svenssonjoel/Mattie/README.md

# Mattie
stM32f4 lATTIcE - MATTIE - A PCB with an STM32f4 and a LATTICE FPGA
