svenssonjoel/Mattie/hardware/mattie_v0/mattie_v0.kicad_pcb

## KiCad design hardware/mattie_v0/mattie_v0.kicad_pcb (2020-05-09)

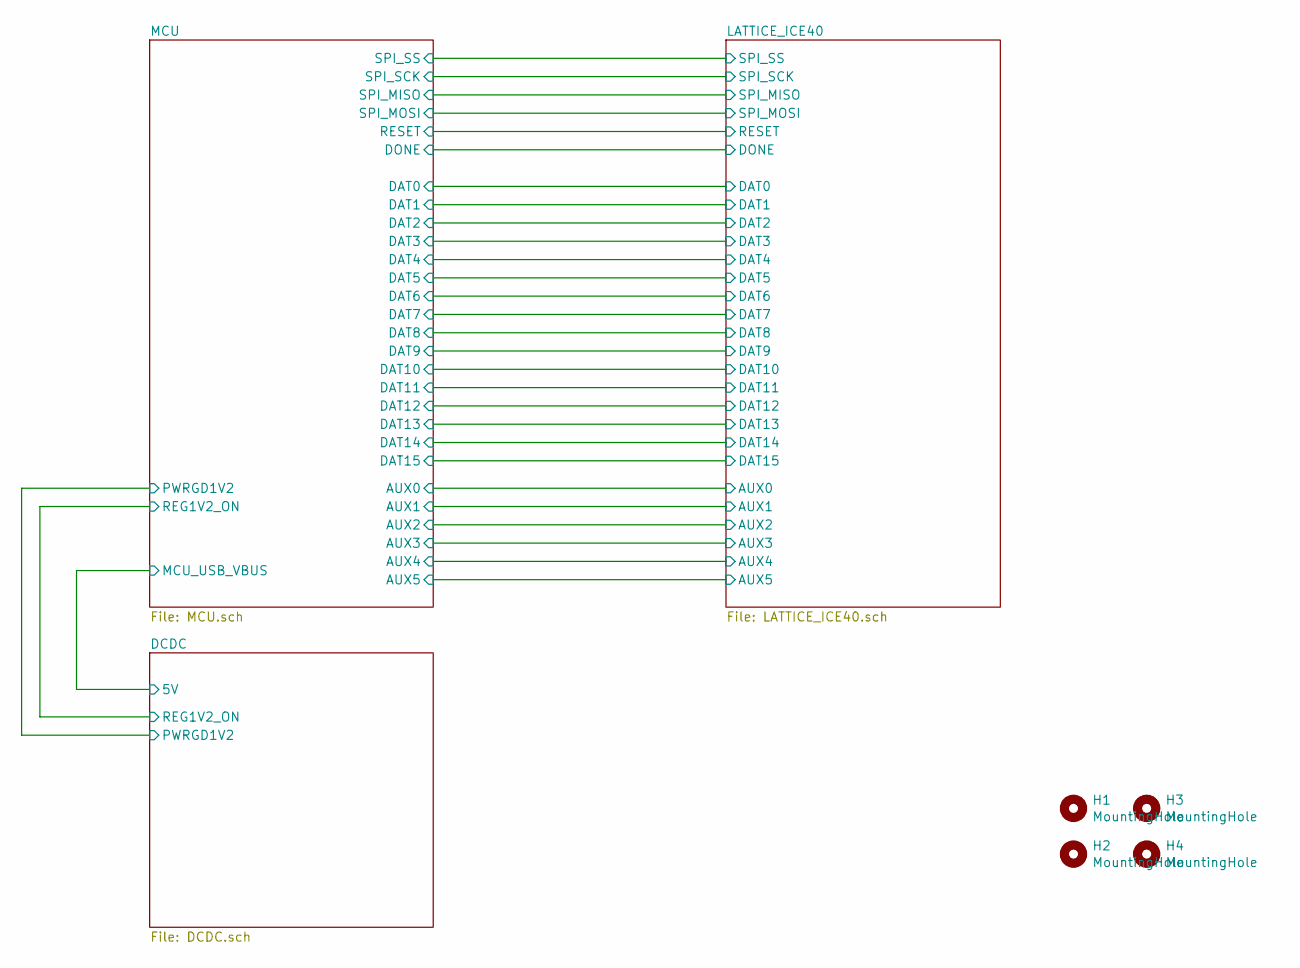
[picture p8: schematic mattie_v0.sch, Mattie Version 0]

Parts:
H1, H2, H3, H4: MountingHole; MountingHole_3.2mm_M3

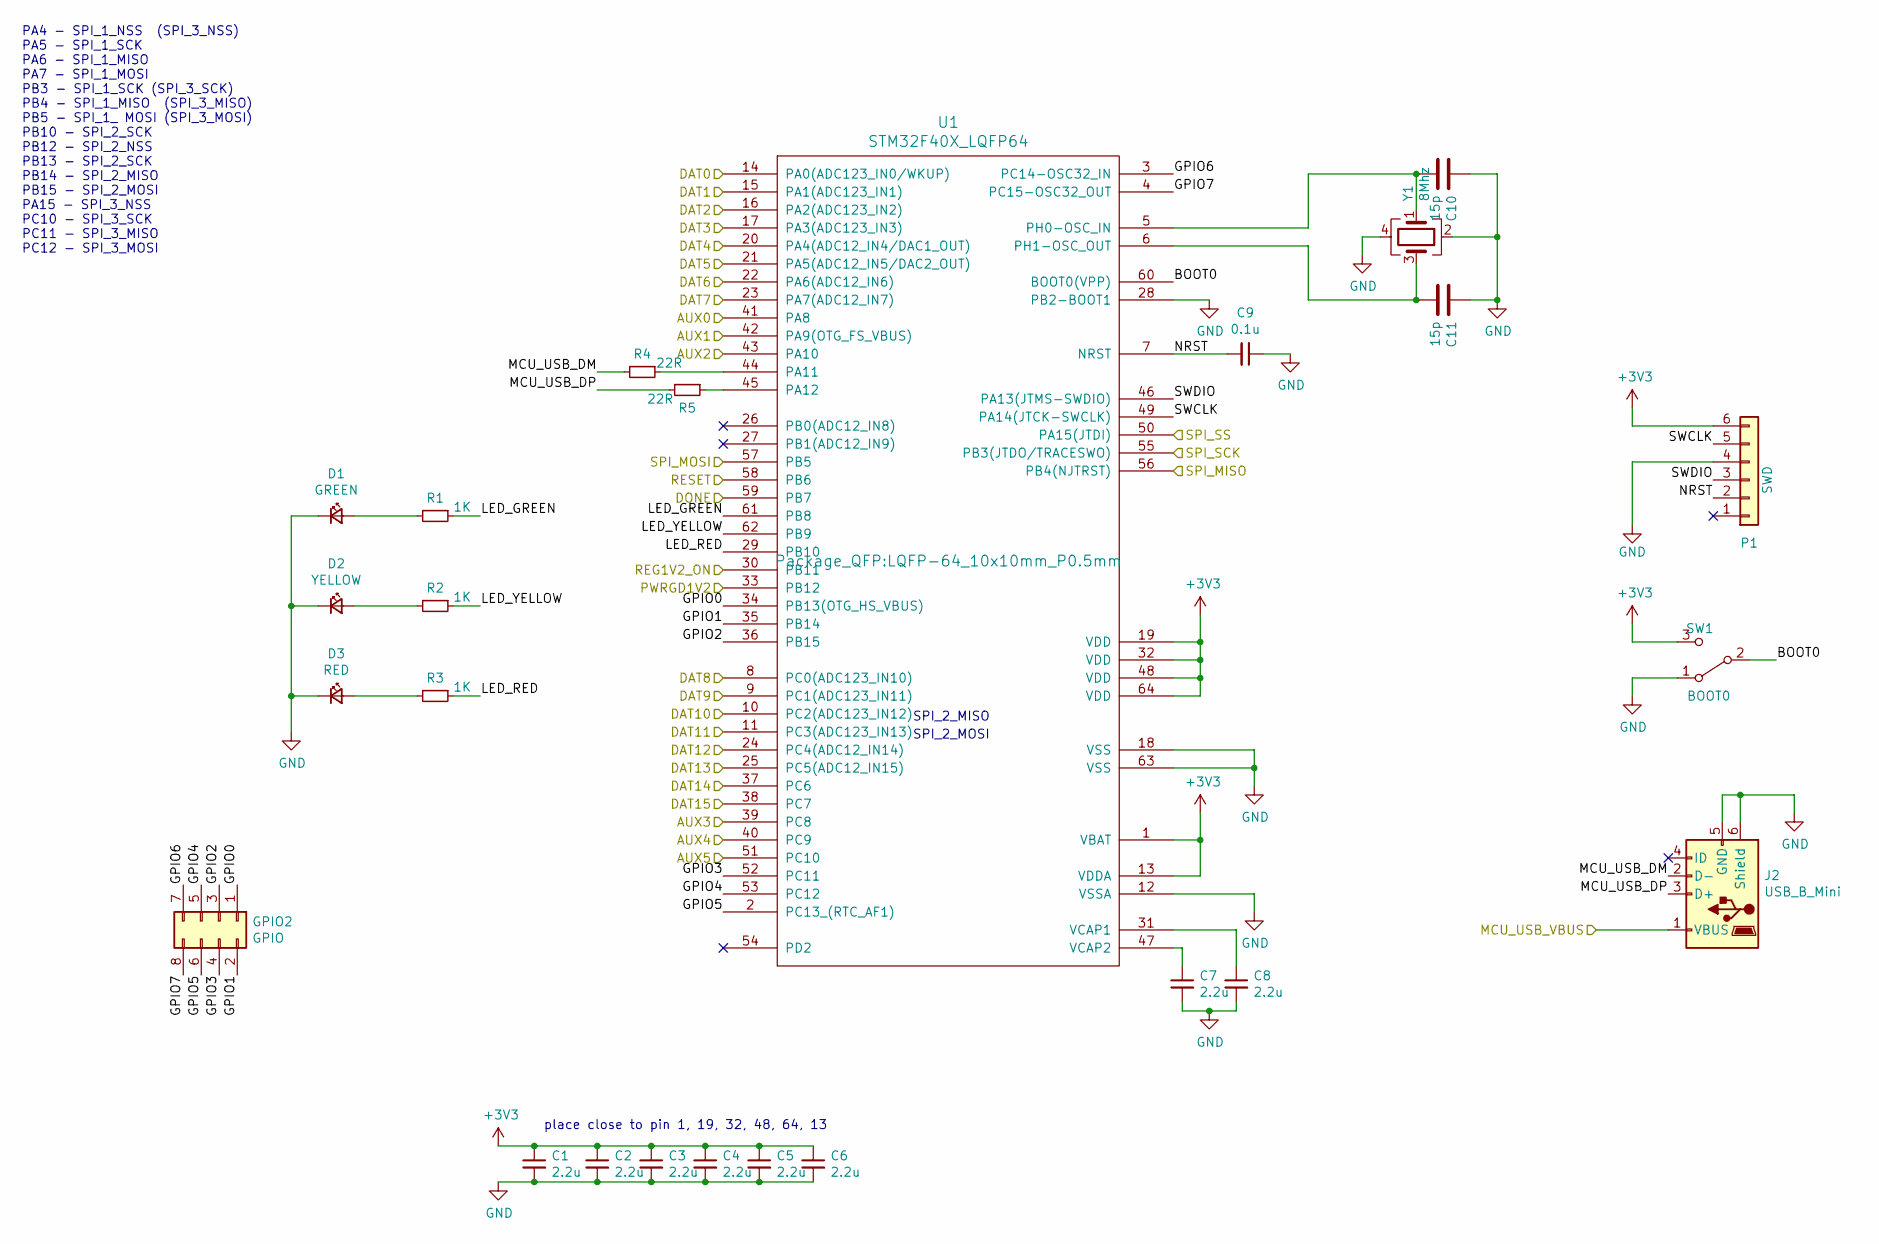
[picture p9: schematic MCU.sch, Mattie Version 0]

Parts:
C1, C2, C3, C4, C5, C6, C7, C8: 2.2u; C_0603_1608Metric
C9: 0.1u; C_0603_1608Metric
C10, C11: 15p; C_0603_1608Metric
D1: GREEN; LED_0603_1608Metric
D2: YELLOW; LED_0603_1608Metric
D3: RED; LED_0603_1608Metric
GPIO2: GPIO; PinHeader_2x04_P2.54mm_Vertical
J2: USB_B_Mini; USB_Mini-B_Lumberg_2486_01_Horizontal
P1: SWD; JST_PH_B6B-PH-K_1x06_P2.00mm_Vertical
R1, R2, R3: 1K; R_0603_1608Metric
R4, R5: 22R; R_0603_1608Metric
SW1: BOOT0; SW_SPDT_PCM12
U1: STM32F40X_LQFP64; LQFP-64_10x10mm_P0.5mm
Y1: 8Mhz; Crystal_SMD_5032-4Pin_5.0x3.2mm

Connections:
+3V3: C1.1, C2.1, C3.1, C4.1, C5.1, C6.1, P1.6, SW1.3 (C), U1.1 (VBAT), U1.13 (VDDA), U1.19 (VDD), U1.32 (VDD), U1.48 (VDD), U1.64 (VDD); also elsewhere on the board
/DCDC/5V: J2.1 (VBUS); also elsewhere on the board
/DCDC/PWRGD1V2: U1.33 (PB12); also elsewhere on the board
/DCDC/REG1V2_ON: U1.30 (PB11); also elsewhere on the board
/LATTICE_ICE40/AUX0: U1.41 (PA8); also elsewhere on the board
/LATTICE_ICE40/AUX1: U1.42 (PA9(OTG_FS_VBUS)); also elsewhere on the board
/LATTICE_ICE40/AUX2: U1.43 (PA10); also elsewhere on the board
/LATTICE_ICE40/AUX3: U1.39 (PC8); also elsewhere on the board
/LATTICE_ICE40/AUX4: U1.40 (PC9); also elsewhere on the board
/LATTICE_ICE40/AUX5: U1.51 (PC10); also elsewhere on the board
/LATTICE_ICE40/DAT0: U1.14 (PA0(ADC123_IN0/WKUP)); also elsewhere on the board
/LATTICE_ICE40/DAT1: U1.15 (PA1(ADC123_IN1)); also elsewhere on the board
/LATTICE_ICE40/DAT2: U1.16 (PA2(ADC123_IN2)); also elsewhere on the board
/LATTICE_ICE40/DAT3: U1.17 (PA3(ADC123_IN3)); also elsewhere on the board
/LATTICE_ICE40/DAT4: U1.20 (PA4(ADC12_IN4/DAC1_OUT)); also elsewhere on the board
/LATTICE_ICE40/DAT5: U1.21 (PA5(ADC12_IN5/DAC2_OUT)); also elsewhere on the board
/LATTICE_ICE40/DAT6: U1.22 (PA6(ADC12_IN6)); also elsewhere on the board
/LATTICE_ICE40/DAT7: U1.23 (PA7(ADC12_IN7)); also elsewhere on the board
/LATTICE_ICE40/DAT8: U1.8 (PC0(ADC123_IN10)); also elsewhere on the board
/LATTICE_ICE40/DAT9: U1.9 (PC1(ADC123_IN11)); also elsewhere on the board
/LATTICE_ICE40/DAT10: U1.10 (PC2(ADC123_IN12)); also elsewhere on the board
/LATTICE_ICE40/DAT11: U1.11 (PC3(ADC123_IN13)); also elsewhere on the board
/LATTICE_ICE40/DAT12: U1.24 (PC4(ADC12_IN14)); also elsewhere on the board
/LATTICE_ICE40/DAT13: U1.25 (PC5(ADC12_IN15)); also elsewhere on the board
/LATTICE_ICE40/DAT14: U1.37 (PC6); also elsewhere on the board
/LATTICE_ICE40/DAT15: U1.38 (PC7); also elsewhere on the board
/LATTICE_ICE40/DONE: U1.59 (PB7); also elsewhere on the board
/LATTICE_ICE40/RESET: U1.58 (PB6); also elsewhere on the board
/LATTICE_ICE40/SPI_MISO: U1.56 (PB4(NJTRST)); also elsewhere on the board
/LATTICE_ICE40/SPI_MOSI: U1.57 (PB5); also elsewhere on the board
/LATTICE_ICE40/SPI_SCK: U1.55 (PB3(JTDO/TRACESWO)); also elsewhere on the board
/LATTICE_ICE40/SPI_SS: U1.50 (PA15(JTDI)); also elsewhere on the board
/MCU/BOOT0: SW1.2 (B), U1.60 (BOOT0(VPP))
/MCU/GPIO0: GPIO2.1, U1.34 (PB13(OTG_HS_VBUS))
/MCU/GPIO1: GPIO2.2, U1.35 (PB14)
/MCU/GPIO2: GPIO2.3, U1.36 (PB15)
/MCU/GPIO3: GPIO2.4, U1.52 (PC11)
/MCU/GPIO4: GPIO2.5, U1.53 (PC12)
/MCU/GPIO5: GPIO2.6, U1.2 (PC13_(RTC_AF1))
/MCU/GPIO6: GPIO2.7, U1.3 (PC14-OSC32_IN)
/MCU/GPIO7: GPIO2.8, U1.4 (PC15-OSC32_OUT)
/MCU/LED_GREEN: R1.1, U1.61 (PB8)
/MCU/LED_RED: R3.1, U1.29 (PB10)
/MCU/LED_YELLOW: R2.1, U1.62 (PB9)
/MCU/MCU_USB_DM: J2.2 (D-), R4.2
/MCU/MCU_USB_DP: J2.3 (D+), R5.2
/MCU/NRST: C9.2, P1.2, U1.7 (NRST)
/MCU/SWCLK: P1.5, U1.49 (PA14(JTCK-SWCLK))
/MCU/SWDIO: P1.3, U1.46 (PA13(JTMS-SWDIO))
GND: C1.2, C2.2, C3.2, C4.2, C5.2, C6.2, C7.2, C8.2, C9.1, C10.1, C11.1, D1.1 (K), D2.1 (K), D3.1 (K), J2.5 (GND), J2.6 (Shield), P1.4, SW1.1 (A), U1.12 (VSSA), U1.18 (VSS), U1.28 (PB2-BOOT1), U1.63 (VSS), Y1.2, Y1.4; also elsewhere on the board
unnamed: C7.1, U1.47 (VCAP2)
unnamed: C8.1, U1.31 (VCAP1)
unnamed: C10.2, U1.5 (PH0-OSC_IN), Y1.1
unnamed: C11.2, U1.6 (PH1-OSC_OUT), Y1.3
unnamed: D1.2 (A), R1.2
unnamed: D2.2 (A), R2.2
unnamed: D3.2 (A), R3.2
unnamed: R4.1, U1.44 (PA11)
unnamed: R5.1, U1.45 (PA12)

Notes on the sheet:
SPI_2_MISO
SPI_2_MOSI
PA4 - SPI_1_NSS (SPI_3_NSS) PA5 - SPI_1_SCK PA6 - SPI_1_MISO PA7 - SPI_1_MOSI PB3 - SPI_1_SCK (SPI_3_SCK) PB4 - SPI_1_MISO (SPI_3_MISO) PB5 - SPI_1_ MOSI (SPI_3_MOSI) PB10 - SPI_2_SCK PB12 - SPI_2_NSS PB13 - SPI_2_SCK PB14 - SPI_2_MISO PB15 - SPI_2_MOSI PA15 - SPI_3_NSS PC10 - SPI_3_SCK PC11 - SPI_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
place close to pin 1, 19, 32, 48, 64, 13

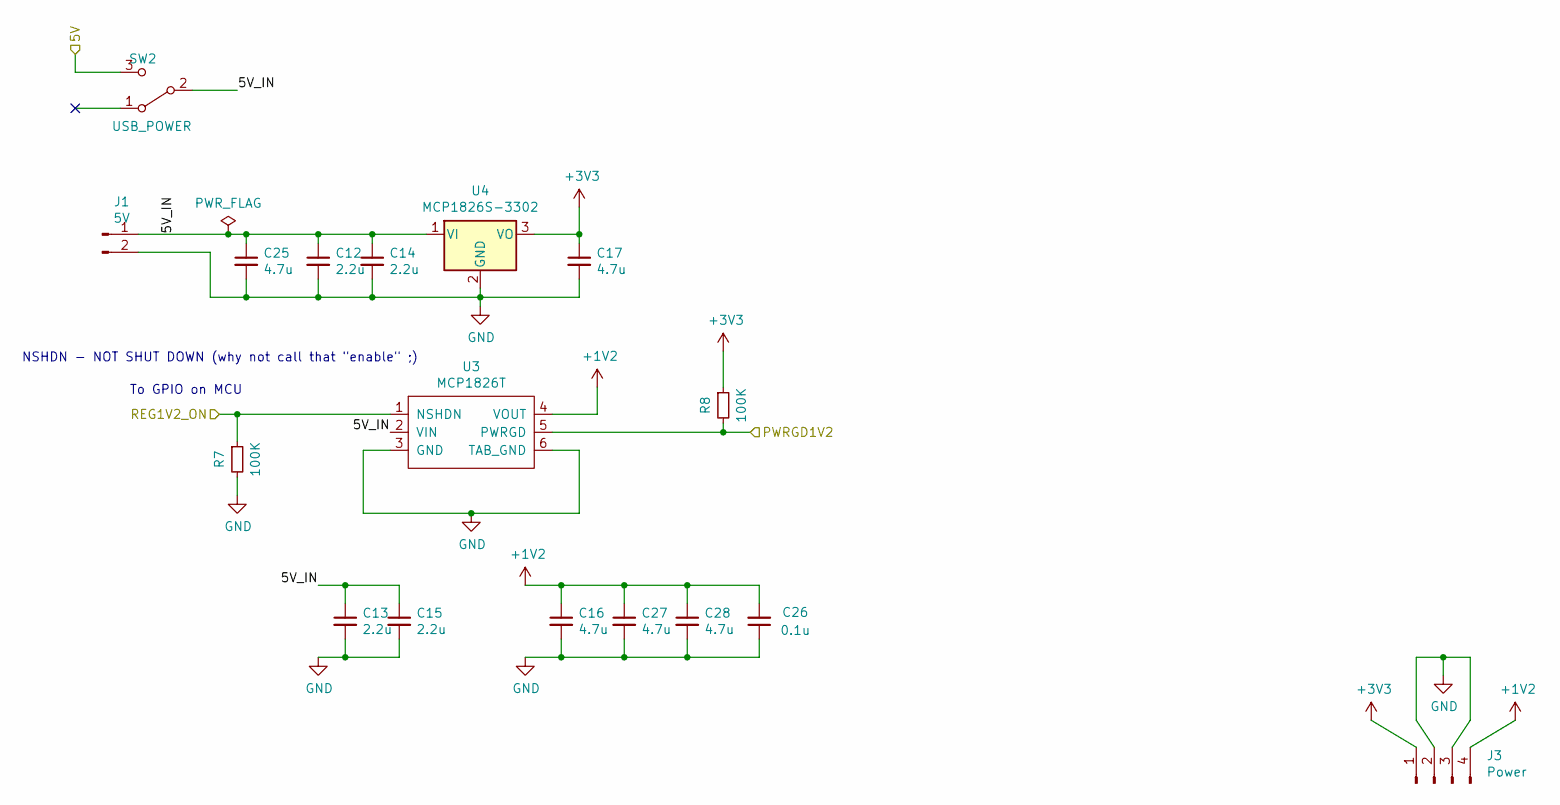
[picture p10: schematic DCDC.sch, Mattie Version 0]

Parts:
C12, C13, C14, C15: 2.2u; C_0603_1608Metric
C16, C17, C25, C27, C28: 4.7u; C_0603_1608Metric
C26: 0.1u; C_0603_1608Metric
J1: 5V; PinHeader_1x02_P2.54mm_Vertical
J3: Power; PinHeader_1x04_P2.54mm_Vertical
R7, R8: 100K; R_0603_1608Metric
SW2: USB_POWER; SW_SPDT_PCM12
U3: MCP1826T; SOT-223-6
U4: MCP1826S-3302; SOT-223-3_TabPin2

Connections:
+1V2: C16.1, C26.2, C27.1, C28.1, J3.4, U3.4 (VOUT); also elsewhere on the board
+3V3: C17.1, J3.1, R8.1, U4.3 (VO); also elsewhere on the board
/DCDC/5V: SW2.3 (C); also elsewhere on the board
/DCDC/5V_IN: C12.1, C13.1, C14.1, C15.1, C25.1, J1.1, SW2.2 (B), U3.2 (VIN), U4.1 (VI)
/DCDC/PWRGD1V2: R8.2, U3.5 (PWRGD); also elsewhere on the board
/DCDC/REG1V2_ON: R7.1, U3.1 (NSHDN); also elsewhere on the board
GND: C12.2, C13.2, C14.2, C15.2, C16.2, C17.2, C25.2, C26.1, C27.2, C28.2, J1.2, J3.2, J3.3, R7.2, U3.3 (GND), U3.6 (TAB_GND), U4.2 (GND); also elsewhere on the board

Notes on the sheet:
To GPIO on MCU
NSHDN - NOT SHUT DOWN (why not call that "enable" ;)

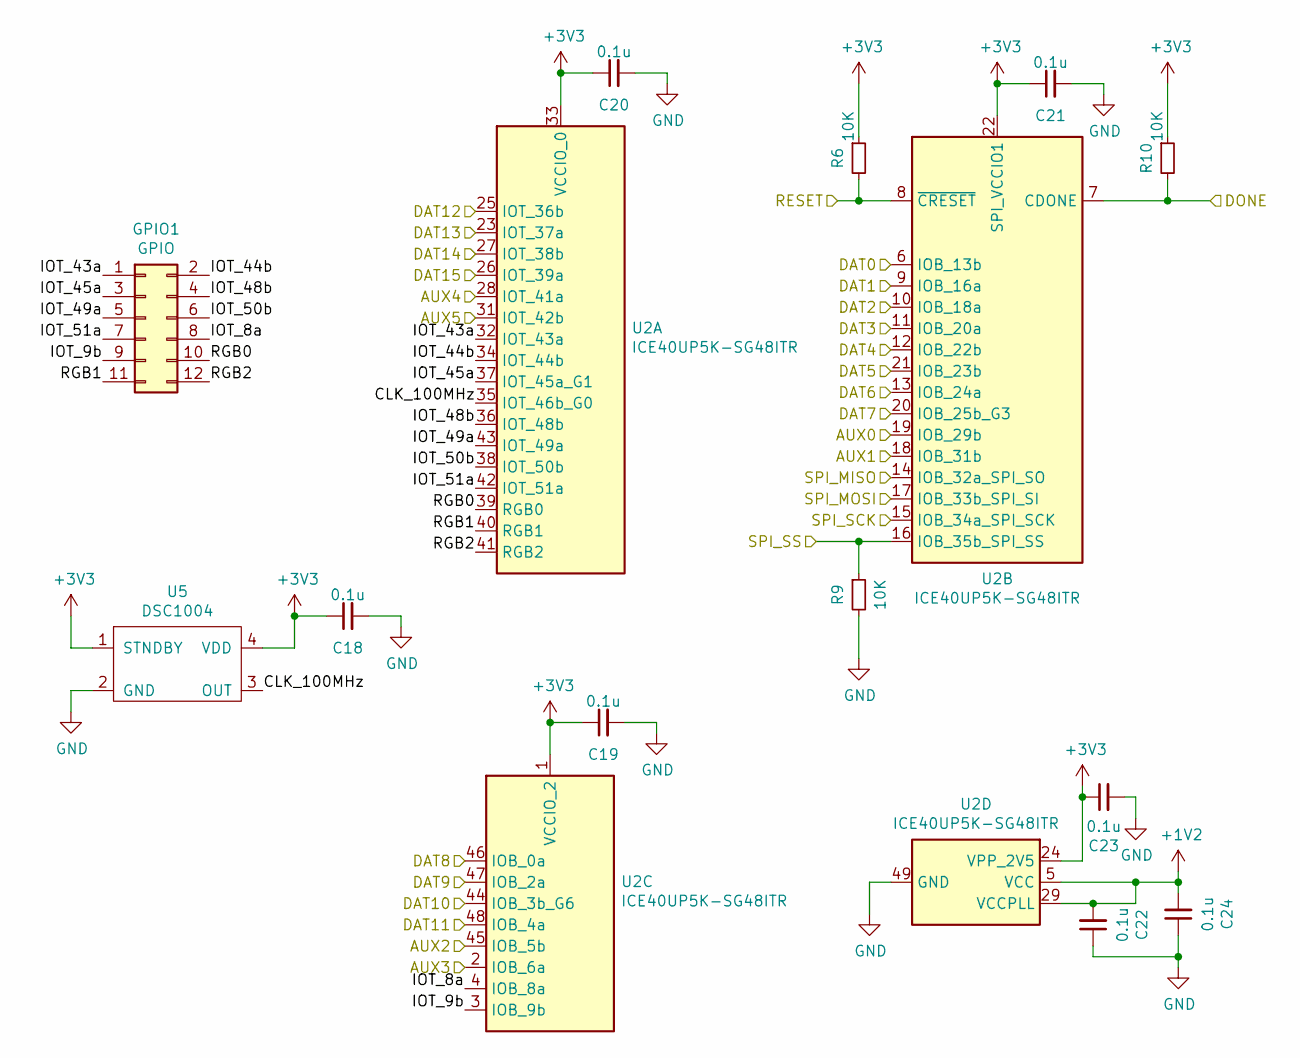
[picture p11: schematic LATTICE_ICE40.sch, Mattie Version 0]

Parts:
C18, C19, C20, C21, C22, C23, C24: 0.1u; C_0603_1608Metric
GPIO1: GPIO; PinHeader_2x06_P2.54mm_Vertical
R6, R9, R10: 10K; R_0603_1608Metric
U2: ICE40UP5K-SG48ITR; QFN-48-1EP_7x7mm_P0.5mm_EP5.45x5.45mm_ThermalVias
U5: DSC1004

Connections:
+1V2: C22.2, C24.2, U2.5 (VCC), U2.29 (VCCPLL), U2.30 (VCC); also elsewhere on the board
+3V3: C18.1, C19.1, C20.1, C21.1, C23.1, R6.1, R10.1, U2.1 (VCCIO_2), U2.22 (SPI_VCCIO1), U2.24 (VPP_2V5), U2.33 (VCCIO_0), U5.1 (STNDBY), U5.4 (VDD); also elsewhere on the board
/LATTICE_ICE40/AUX0: U2.19 (IOB_29b); also elsewhere on the board
/LATTICE_ICE40/AUX1: U2.18 (IOB_31b); also elsewhere on the board
/LATTICE_ICE40/AUX2: U2.45 (IOB_5b); also elsewhere on the board
/LATTICE_ICE40/AUX3: U2.2 (IOB_6a); also elsewhere on the board
/LATTICE_ICE40/AUX4: U2.28 (IOT_41a); also elsewhere on the board
/LATTICE_ICE40/AUX5: U2.31 (IOT_42b); also elsewhere on the board
/LATTICE_ICE40/CLK_100MHz: U2.35 (IOT_46b_G0), U5.3 (OUT)
/LATTICE_ICE40/DAT0: U2.6 (IOB_13b); also elsewhere on the board
/LATTICE_ICE40/DAT1: U2.9 (IOB_16a); also elsewhere on the board
/LATTICE_ICE40/DAT2: U2.10 (IOB_18a); also elsewhere on the board
/LATTICE_ICE40/DAT3: U2.11 (IOB_20a); also elsewhere on the board
/LATTICE_ICE40/DAT4: U2.12 (IOB_22b); also elsewhere on the board
/LATTICE_ICE40/DAT5: U2.21 (IOB_23b); also elsewhere on the board
/LATTICE_ICE40/DAT6: U2.13 (IOB_24a); also elsewhere on the board
/LATTICE_ICE40/DAT7: U2.20 (IOB_25b_G3); also elsewhere on the board
/LATTICE_ICE40/DAT8: U2.46 (IOB_0a); also elsewhere on the board
/LATTICE_ICE40/DAT9: U2.47 (IOB_2a); also elsewhere on the board
/LATTICE_ICE40/DAT10: U2.44 (IOB_3b_G6); also elsewhere on the board
/LATTICE_ICE40/DAT11: U2.48 (IOB_4a); also elsewhere on the board
/LATTICE_ICE40/DAT12: U2.25 (IOT_36b); also elsewhere on the board
/LATTICE_ICE40/DAT13: U2.23 (IOT_37a); also elsewhere on the board
/LATTICE_ICE40/DAT14: U2.27 (IOT_38b); also elsewhere on the board
/LATTICE_ICE40/DAT15: U2.26 (IOT_39a); also elsewhere on the board
/LATTICE_ICE40/DONE: R10.2, U2.7 (CDONE); also elsewhere on the board
/LATTICE_ICE40/IOT_8a: GPIO1.8, U2.4 (IOB_8a)
/LATTICE_ICE40/IOT_9b: GPIO1.9, U2.3 (IOB_9b)
/LATTICE_ICE40/IOT_43a: GPIO1.1, U2.32 (IOT_43a)
/LATTICE_ICE40/IOT_44b: GPIO1.2, U2.34 (IOT_44b)
/LATTICE_ICE40/IOT_45a: GPIO1.3, U2.37 (IOT_45a_G1)
/LATTICE_ICE40/IOT_48b: GPIO1.4, U2.36 (IOT_48b)
/LATTICE_ICE40/IOT_49a: GPIO1.5, U2.43 (IOT_49a)
/LATTICE_ICE40/IOT_50b: GPIO1.6, U2.38 (IOT_50b)
/LATTICE_ICE40/IOT_51a: GPIO1.7, U2.42 (IOT_51a)
/LATTICE_ICE40/RESET: R6.2, U2.8 (~CRESET); also elsewhere on the board
/LATTICE_ICE40/RGB0: GPIO1.10, U2.39 (RGB0)
/LATTICE_ICE40/RGB1: GPIO1.11, U2.40 (RGB1)
/LATTICE_ICE40/RGB2: GPIO1.12, U2.41 (RGB2)
/LATTICE_ICE40/SPI_MISO: U2.14 (IOB_32a_SPI_SO); also elsewhere on the board
/LATTICE_ICE40/SPI_MOSI: U2.17 (IOB_33b_SPI_SI); also elsewhere on the board
/LATTICE_ICE40/SPI_SCK: U2.15 (IOB_34a_SPI_SCK); also elsewhere on the board
/LATTICE_ICE40/SPI_SS: R9.1, U2.16 (IOB_35b_SPI_SS); also elsewhere on the board
GND: C18.2, C19.2, C20.2, C21.2, C22.1, C23.2, C24.1, R9.2, U2.49 (GND), U5.2 (GND); also elsewhere on the board

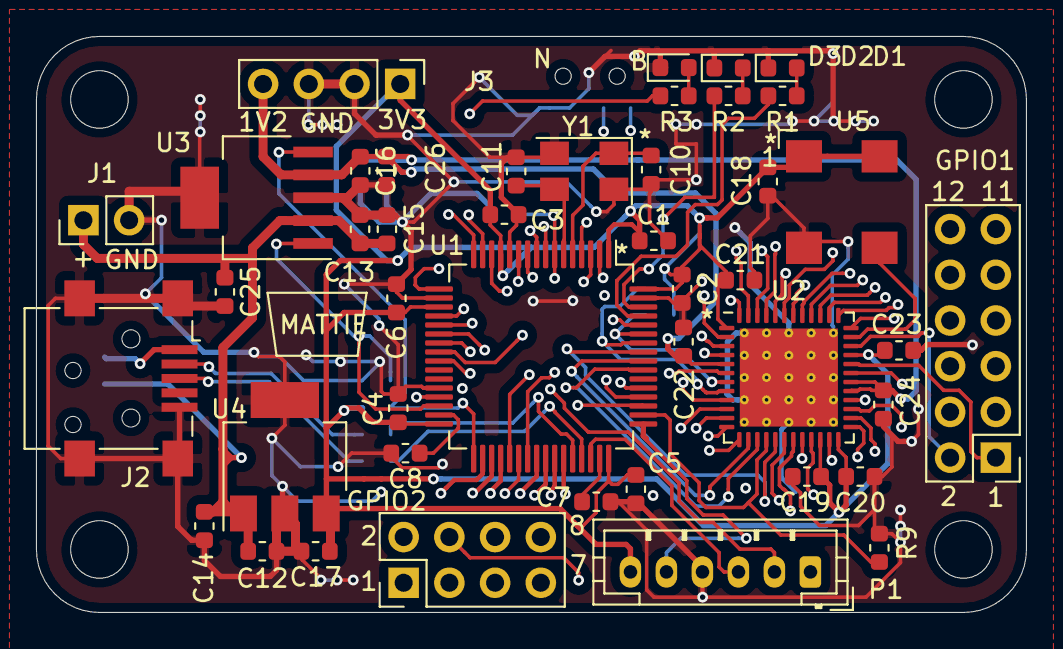
[picture p12: board mattie_v0.kicad_pcb from above]

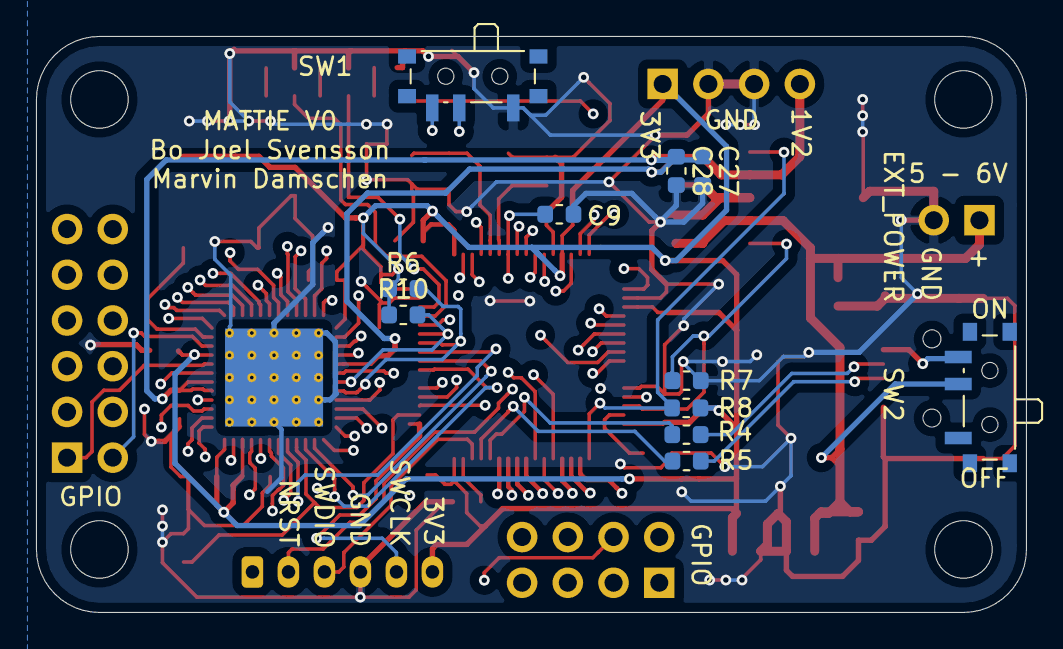
[picture p13: board mattie_v0.kicad_pcb from below]

Board: 4 copper layers, 55.0 x 32.0 mm, 59 parts (11 on the bottom side), 74 nets.
