svenssonjoel/Mattie/(commit log)

2020-04-09 added 1.2V LDO datasheet
2020-04-09 added 3.3V LDO datasheet
2020-04-09 added a dc power connected if we need it
2020-04-09 added another LDO for 2.5V
2020-04-09 added some more iCE40 info
    [iCE40UP 5k Pinout.xlsx]
2020-04-16 started sketching
    [DCDC.sch, LATTICE_ICE40.sch, MCU.sch, mattie_v0.kicad_pcb, mattie_v0.sch, tmp.sch]
2020-04-18 some tweaks
    [DCDC.sch, LATTICE_ICE40.sch, MCU.sch, mattie_v0.sch]
2020-04-21 tweaking and cleaning
    [mattie_v0.kicad_pcb]
2020-04-22 added powerswitch for USB power
    [DCDC.sch, MCU.sch, mattie_v0.kicad_pcb]
2020-04-23 adding some cap
    [DCDC.sch, mattie_v0.kicad_pcb]
2020-04-23 added pullups and pulldowns
    [LATTICE_ICE40.sch, mattie_v0.kicad_pcb]
2020-04-23 Changed some cap values and added extra caps
    [DCDC.sch, mattie_v0.kicad_pcb]
2020-05-07 starting on firmware
    [STM32L4+.ods, stm_spc56ec74a256s_spc56ec74_minimodule_debug_jtag.cfg, stm_xpc560b64_minimodule_debug_jtag.cfg, stm_xpc560b_spc560d40_minimodule_debug_jtag.cfg, stm_xpc560p_minimodule_40mhz_debug_jtag.cfg, stm_xpc563m64_minimodule_debug_jtag.cfg, stm_xpc564a_spc564a70_minimodule_debug_jtag.cfg, stm_xpc56el_minimodule_lockstep_debug_jtag.cfg]
2020-05-07 added schematics for reference
2020-05-07 added some flashing LEDs
2020-05-07 experimenting with SPI... no idea so far
2020-05-07 turning powersupply for FPGA on and checking for pwrgd then performs a reset and checks for success
    [main.c]
2020-05-08 flash yellow led if reset of FPGA is ok
    [mattie_v0.kicad_pcb]
2020-05-09 restored kicad_pcb from old commit
    [mattie_v0.kicad_pcb]
2020-05-11 trying to understand the SPI configuration
